kamilskalka/opticalprobe/3D/readme.txt

This folder contains the 3D model of the whole device aswell as .stl files for the chassis
