kamilskalka/opticalprobe/PCB/readme.txt

This folder contains the KiCad project and gerber files of the PCB
