kamilskalka/opticalprobe/3D/optical probe cap.stl

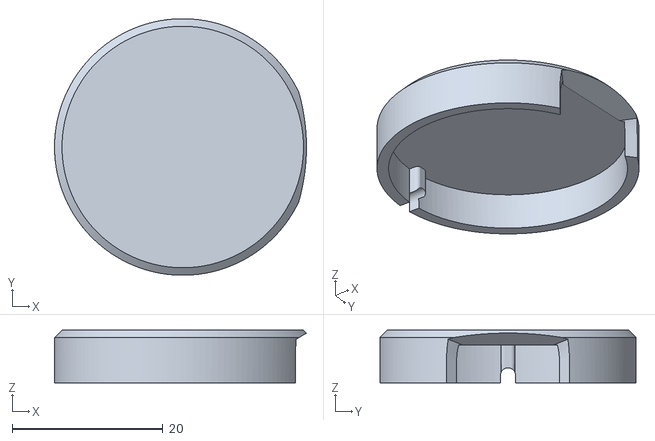
[picture p12: CAD file, 2026-05-06]
3D/optical probe cap.stl
33.4 x 34.0 x 7.00
