kamilskalka/opticalprobe/3D/optical probe body.stl

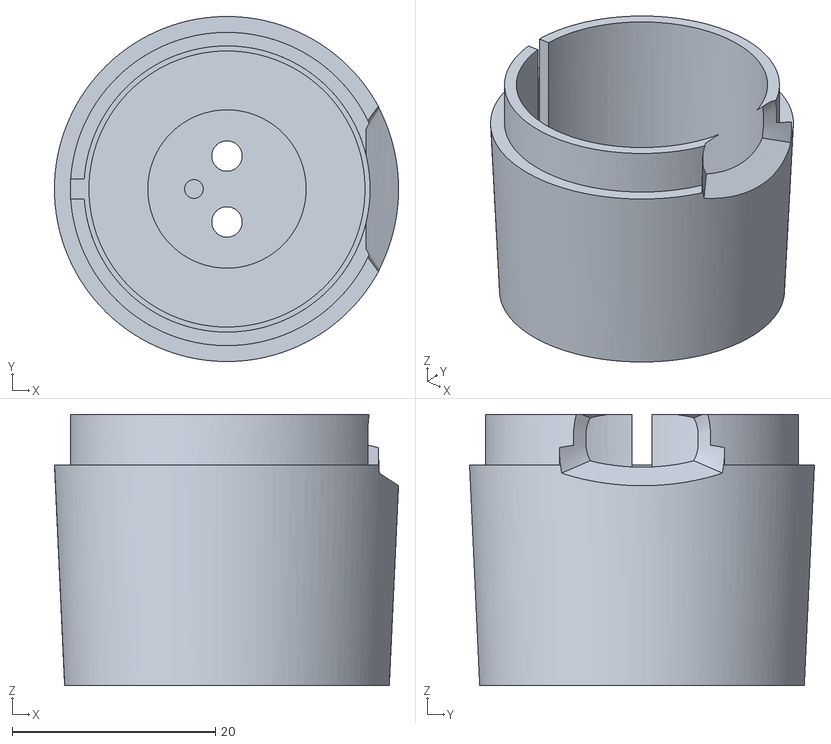
[picture p13: CAD file, 2026-05-06]
3D/optical probe body.stl
33.9 x 34.0 x 26.7
