kamilskalka/opticalprobe/3D/optical probe washer.stl

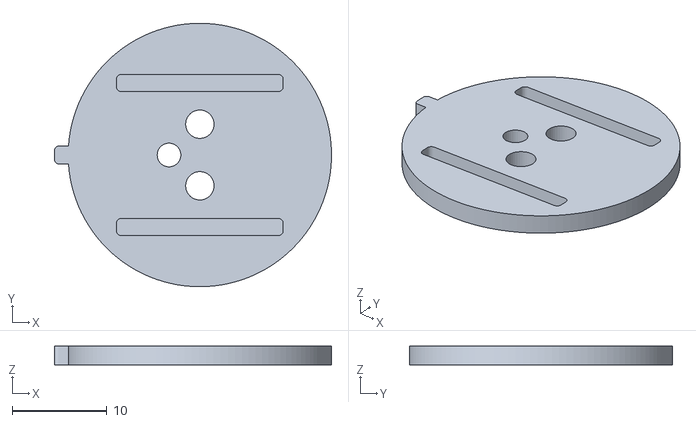
[picture p14: CAD file, 2026-05-06]
3D/optical probe washer.stl
29.2 x 27.8 x 2.00
