kamilskalka/opticalprobe/PCB/optical probe.pdf

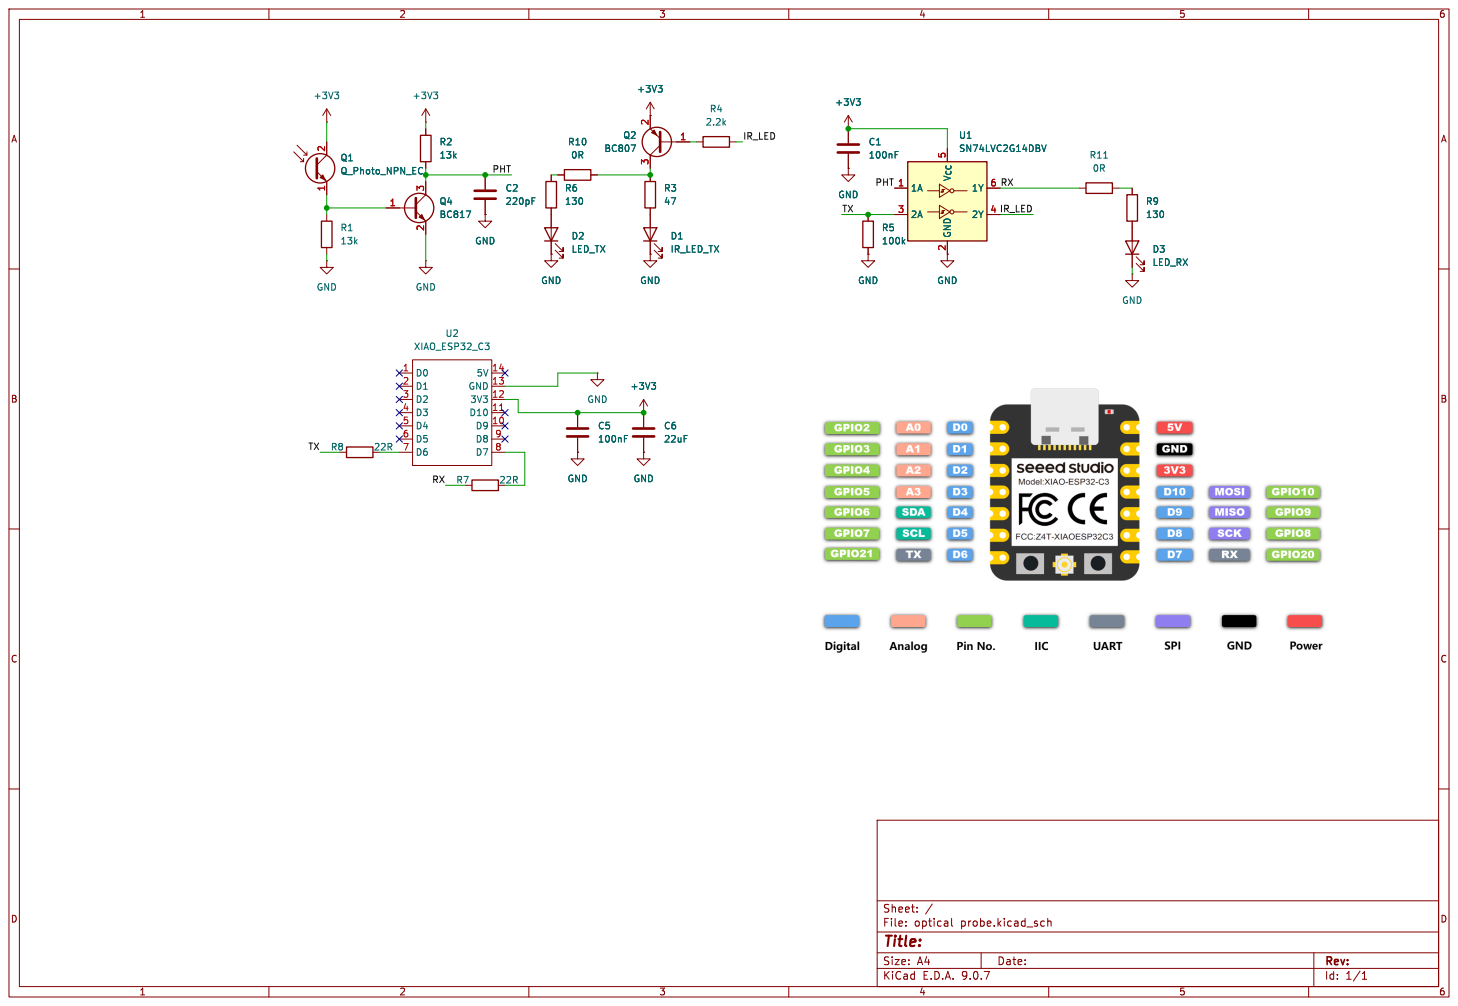
[picture p15: page 1]
