kamilskalka/opticalprobe/PCB/optical probe.kicad_pcb

## KiCad design PCB/optical probe.kicad_pcb (2026-05-06)

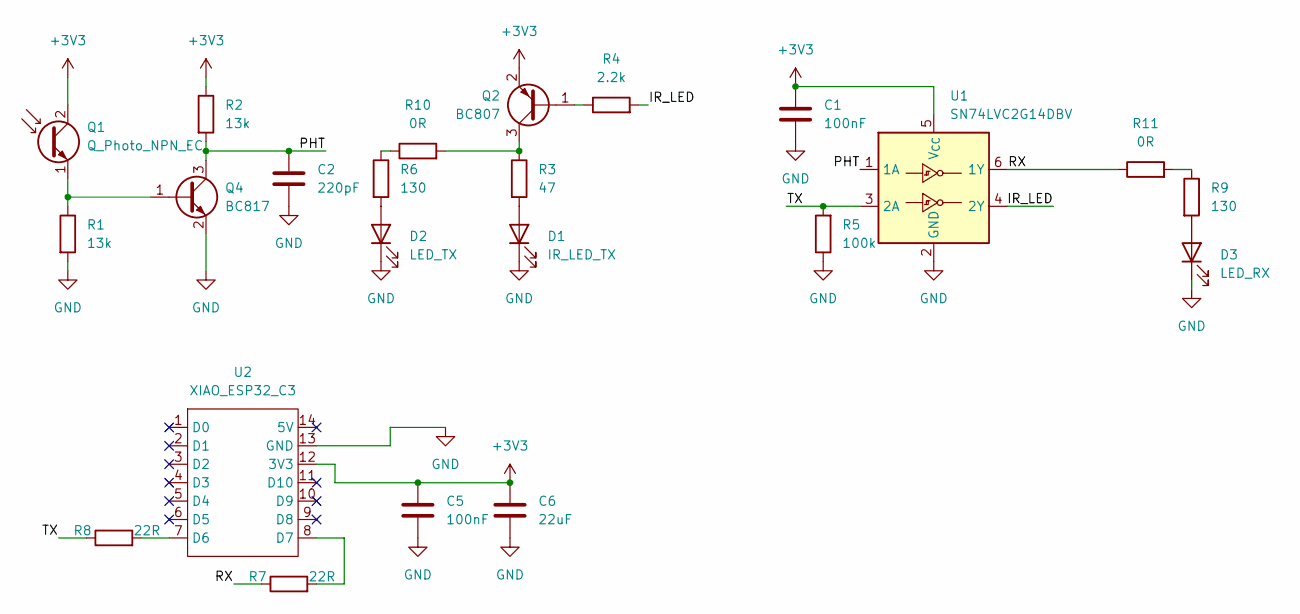
[picture p16: schematic optical probe.kicad_sch]

Parts:
C1, C5: 100nF; C_0805_2012Metric
C2: 220pF; C_0402_1005Metric_Pad0.74x0.62mm_HandSolder
C6: 22uF; C_1206_3216Metric
D1: IR_LED_TX; PT2651BTR8_reverse
D2: LED_TX; LED_0603_1608Metric
D3: LED_RX; LED_0603_1608Metric
Q1: Q_Photo_NPN_EC; PT2651BTR8_reverse
Q2: BC807; SOT-23
Q4: BC817; SOT-23
R1, R2: 13k; R_0402_1005Metric_Pad0.72x0.64mm_HandSolder
R3: 47; R_0402_1005Metric_Pad0.72x0.64mm_HandSolder
R4: 2.2k; R_0402_1005Metric_Pad0.72x0.64mm_HandSolder
R5: 100k; R_0402_1005Metric_Pad0.72x0.64mm_HandSolder
R6, R9: 130; R_0402_1005Metric_Pad0.72x0.64mm_HandSolder
R7, R8: 22R; R_0402_1005Metric_Pad0.72x0.64mm_HandSolder
R10, R11: 0R; R_0402_1005Metric_Pad0.72x0.64mm_HandSolder
U1: SN74LVC2G14DBV; SOT-23-6
U2: XIAO_ESP32_C3

Connections:
+3V3: C1.1, C5.1, C6.1, Q1.2 (C), Q2.2 (E), R2.1, U1.5 (V_{CC}), U2.12 (3V3)
/IR_LED: R4.2, U1.4 (2Y)
/PHT: C2.1, Q4.3 (C), R2.2, U1.1 (1A)
/RX: R7.1, R11.1, U1.6 (1Y)
/TX: R5.2, R8.1, U1.3 (2A)
GND: C1.2, C2.2, C5.2, C6.2, D1.1 (K), D2.1 (K), D3.1 (K), Q4.2 (E), R1.2, R5.1, U1.2 (GND), U2.13 (GND)
unnamed: D1.2 (A), R3.2
unnamed: D2.2 (A), R6.2
unnamed: D3.2 (A), R9.2
unnamed: Q1.1 (E), Q4.1 (B), R1.1
unnamed: Q2.1 (B), R4.1
unnamed: Q2.3 (C), R3.1, R10.2
unnamed: R6.1, R10.1
unnamed: R9.1, R11.2
unnamed: R8.2, U2.7 (D6)
unnamed: R7.2, U2.8 (D7)

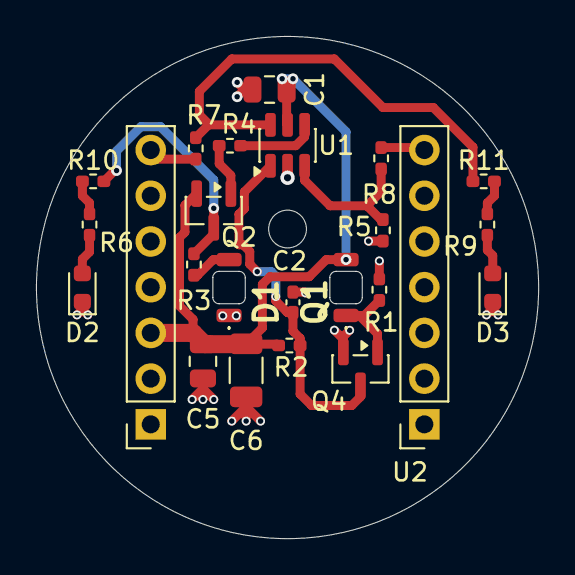
[picture p17: board optical probe.kicad_pcb from above]

Board: 2 copper layers, 27.9 x 27.9 mm, 23 parts (0 on the bottom side), 16 nets.
